arifaydogan0/Pulse-Oximeter/prototip.jpg

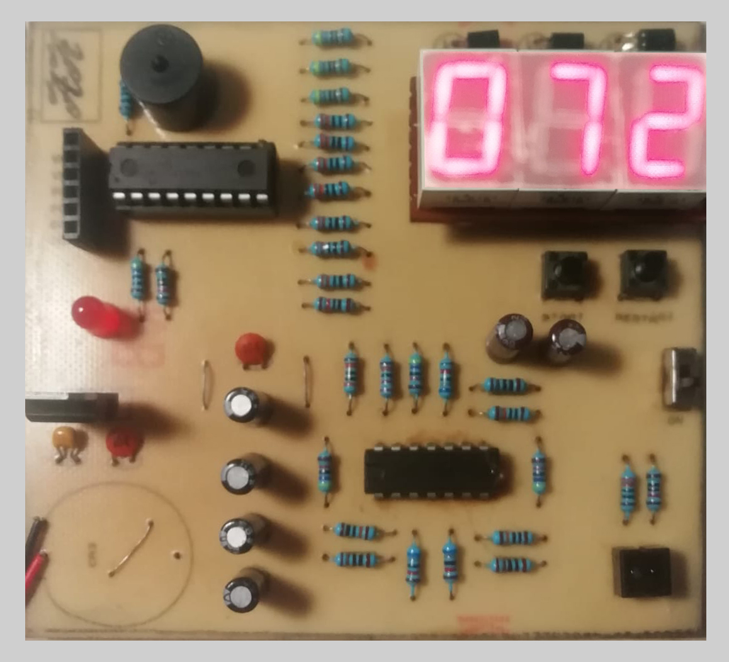
prototip.jpg
