arifaydogan0/Pulse-Oximeter/README.md

<h1 align="center">Pulse Oximeter</h1>
<li> Pic16F628A mikrodenetleyicisi ve CNY70 sensörü üzerine inşaa edilmiştir. </li>
<li> Parmak ucundan(kandaki CO2 miktarının değişiminden kaynaklı renk değişimini izleyerek) nabız ölçümü, %3 tolerans ile sonucu displayde gösterir.</li>

<br>
<br>

<h2 align="center">Devre Şeması</h2>

s0

<br>
<h2 align="center">Pcb Önizleme Ön</h2> 

top-silk

<br>
<h2 align="center">Pcb Önizleme Arka</h2>

bottom-copper

<br>
<h2 align="center">Pcb Önizleme 3D Visualizer</h2>

Ekran görüntüsü 2022-07-05 172732

<br>
<h2 align="center">Prototip</h2>

prototip
