arifaydogan0/Pulse-Oximeter/bottom-copper.png

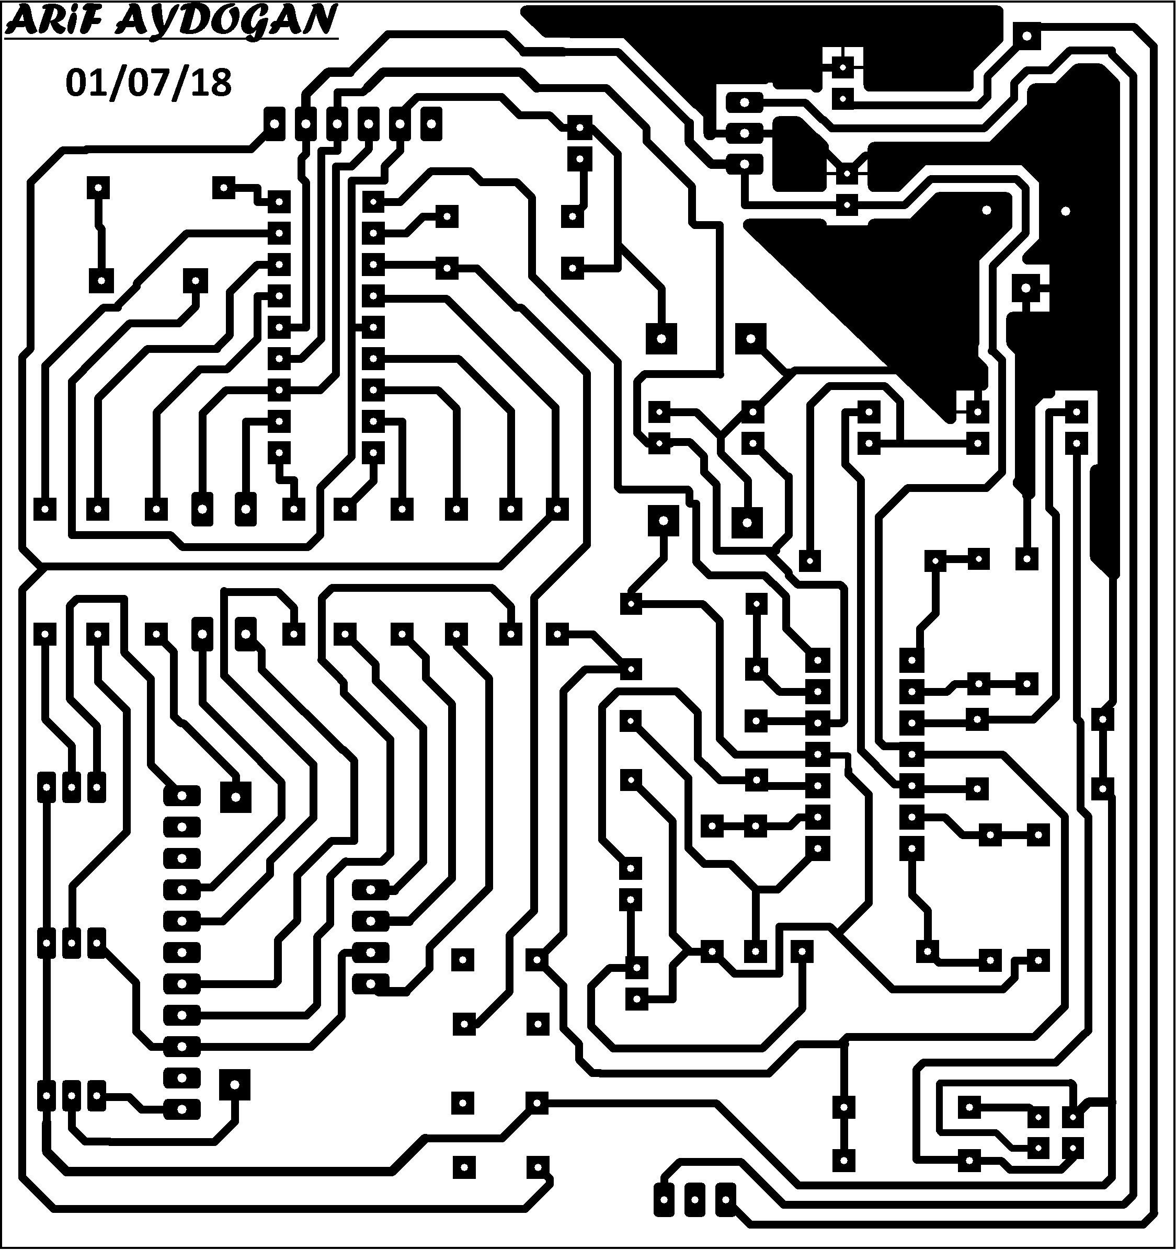
bottom-copper.png
