arifaydogan0/Pulse-Oximeter/Pulse Oximeter Proteus/Çıkarılacak/bottom copper (normal).bmp

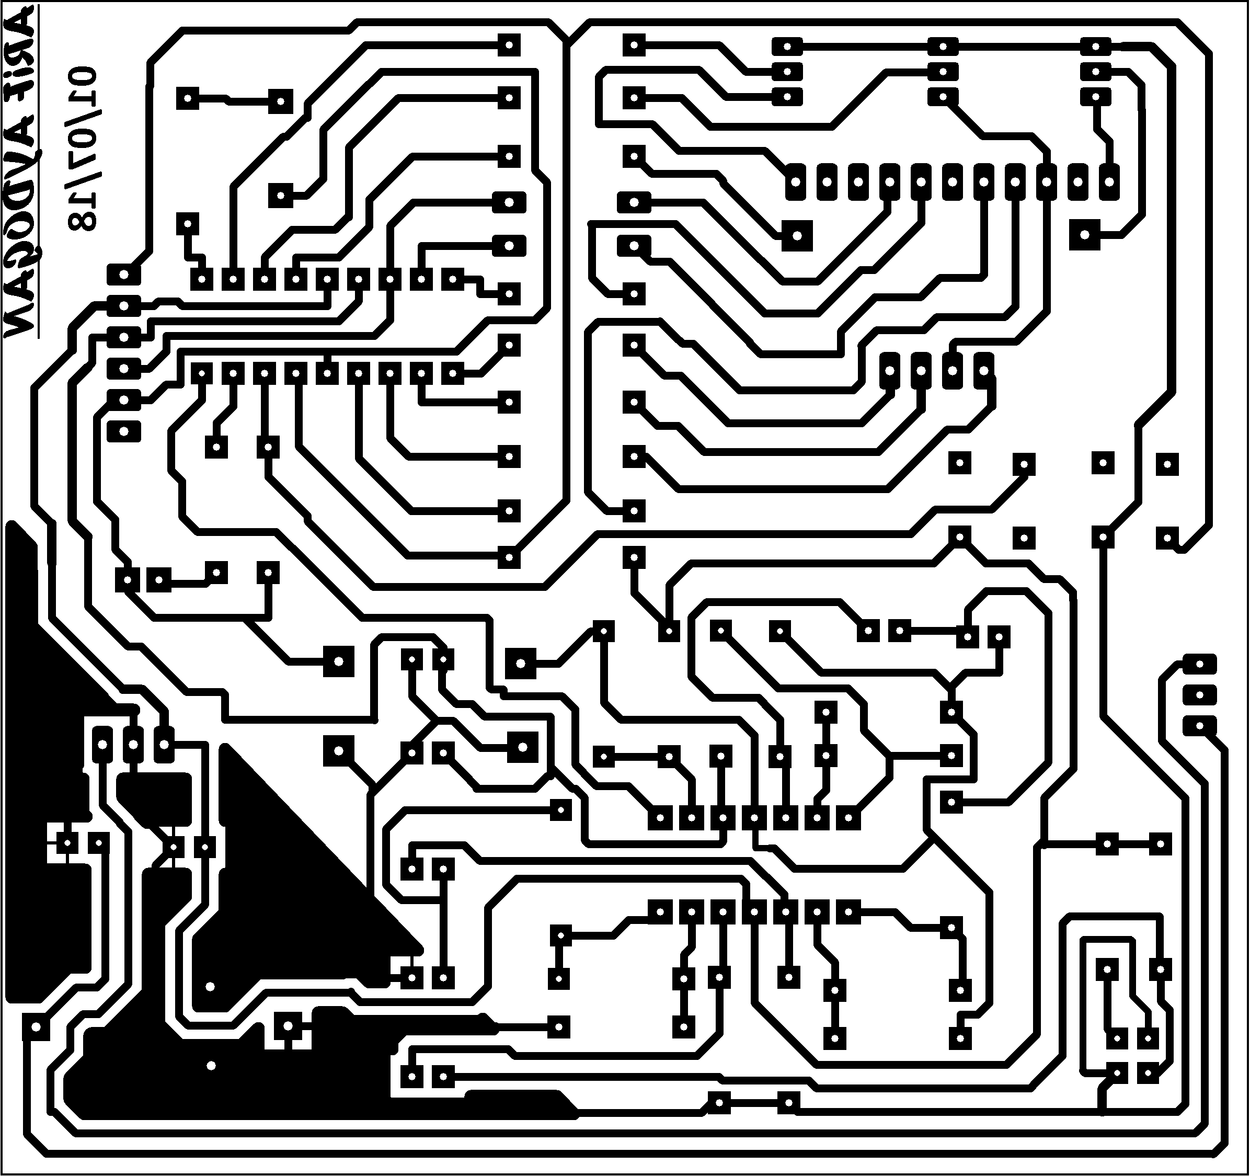
Pulse Oximeter Proteus/Çıkarılacak/bottom copper (normal).bmp
