arifaydogan0/Pulse-Oximeter/Pulse Oximeter Proteus/Çıkarılacak/top silk (ters).bmp

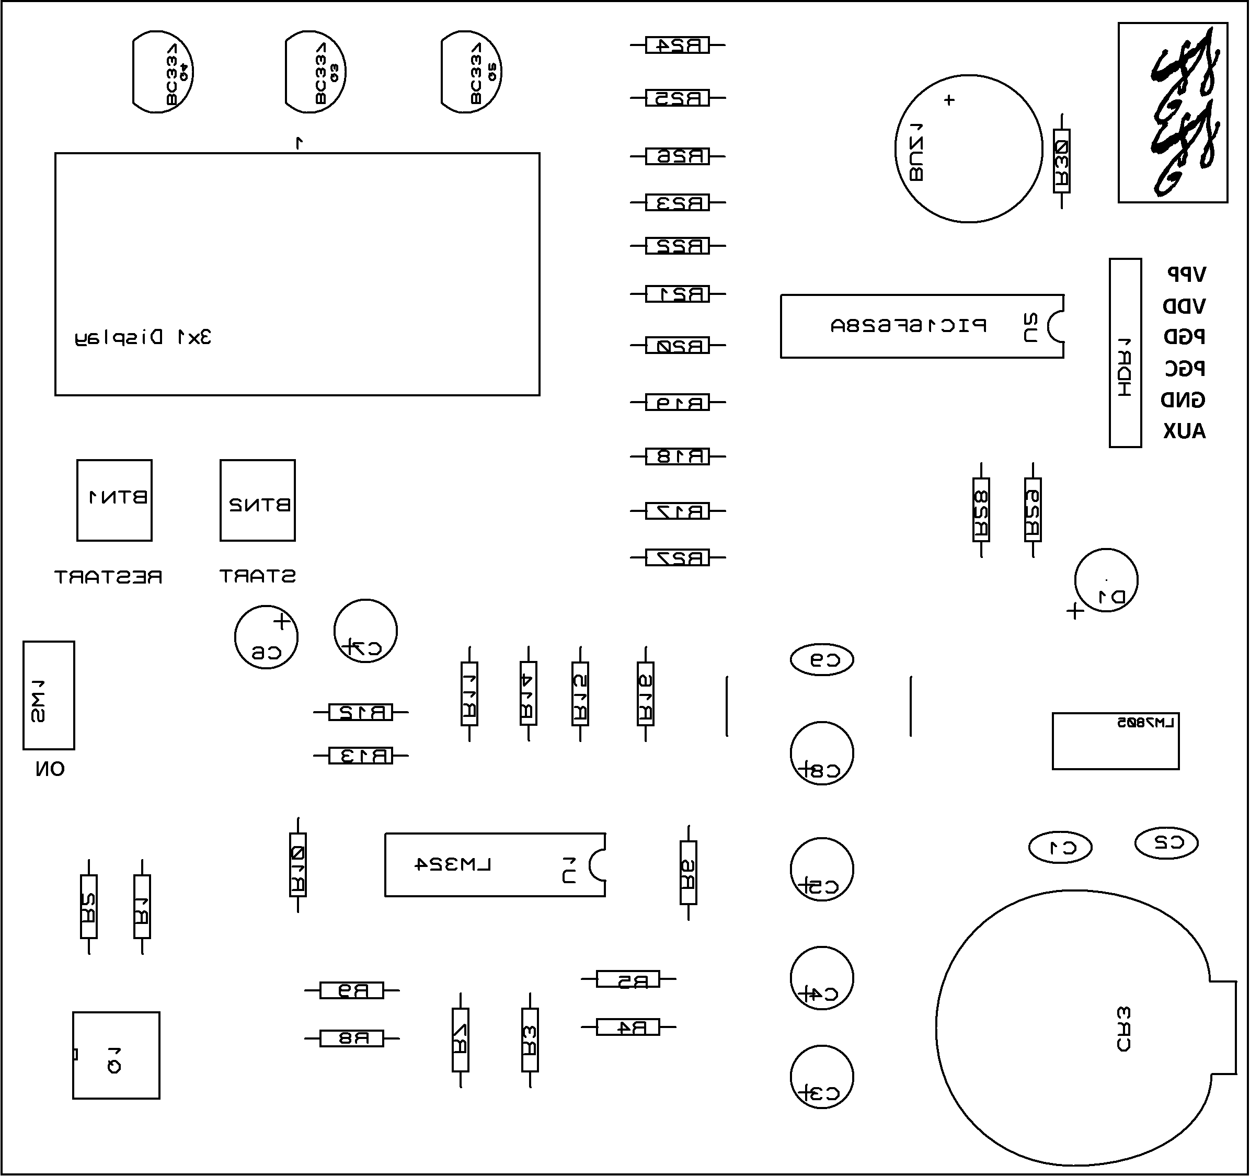
Pulse Oximeter Proteus/Çıkarılacak/top silk (ters).bmp
