arifaydogan0/Pulse-Oximeter/s0.png

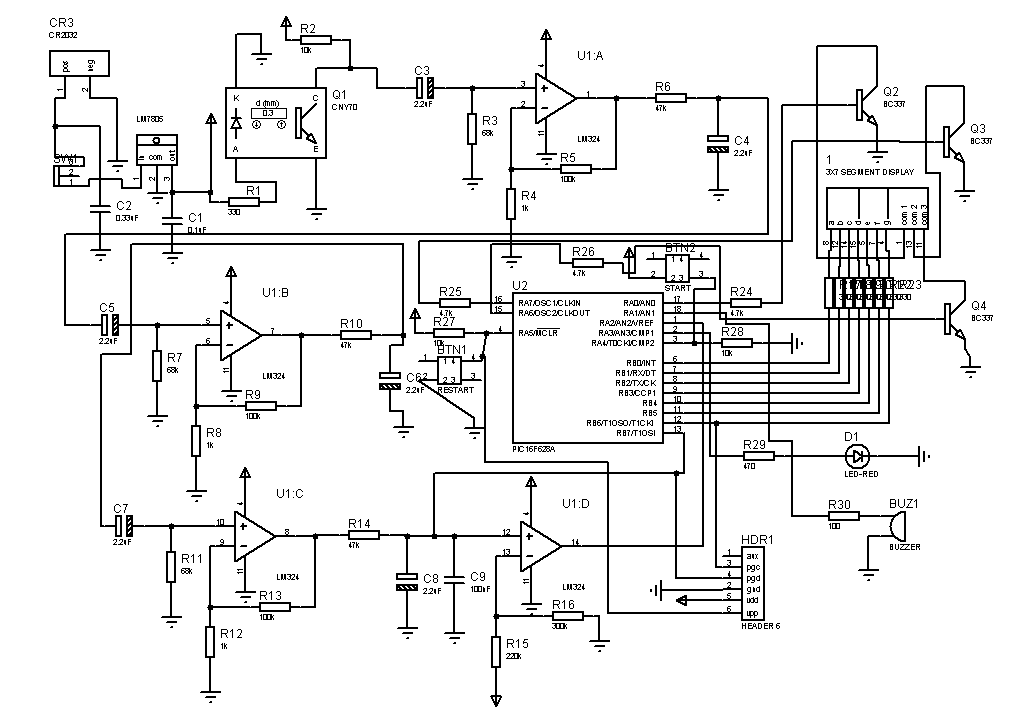
s0.png
