arifaydogan0/Pulse-Oximeter/top-silk.png

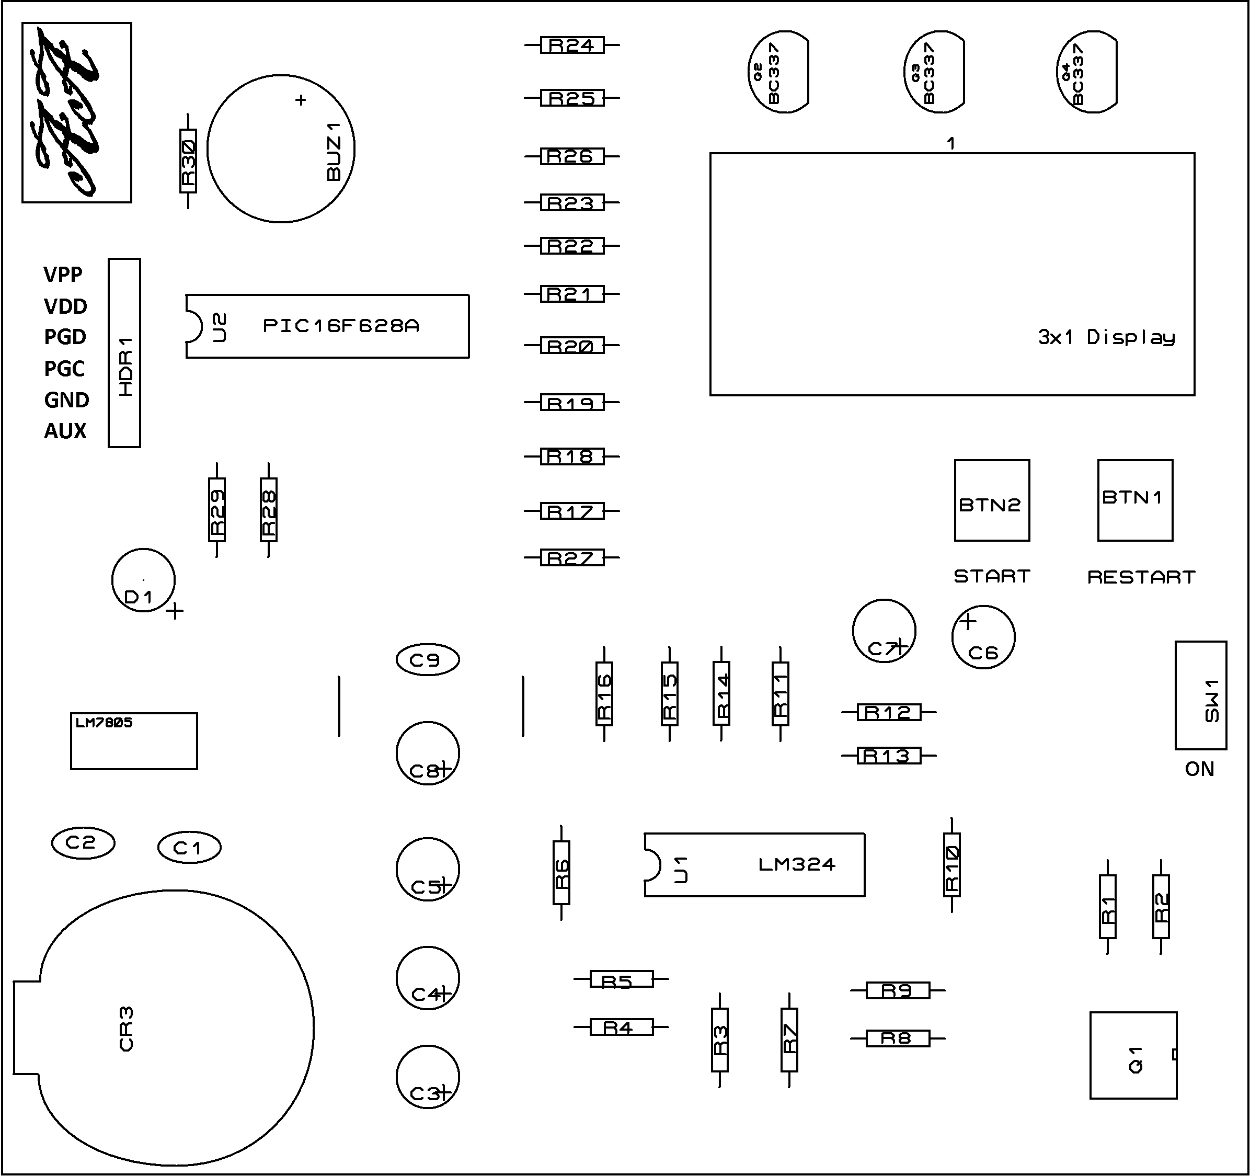
top-silk.png
