arifaydogan0/Pulse-Oximeter/Pulse Oximeter Proteus/Çıkarılacak/top silk(mirrorlanacak).pdf

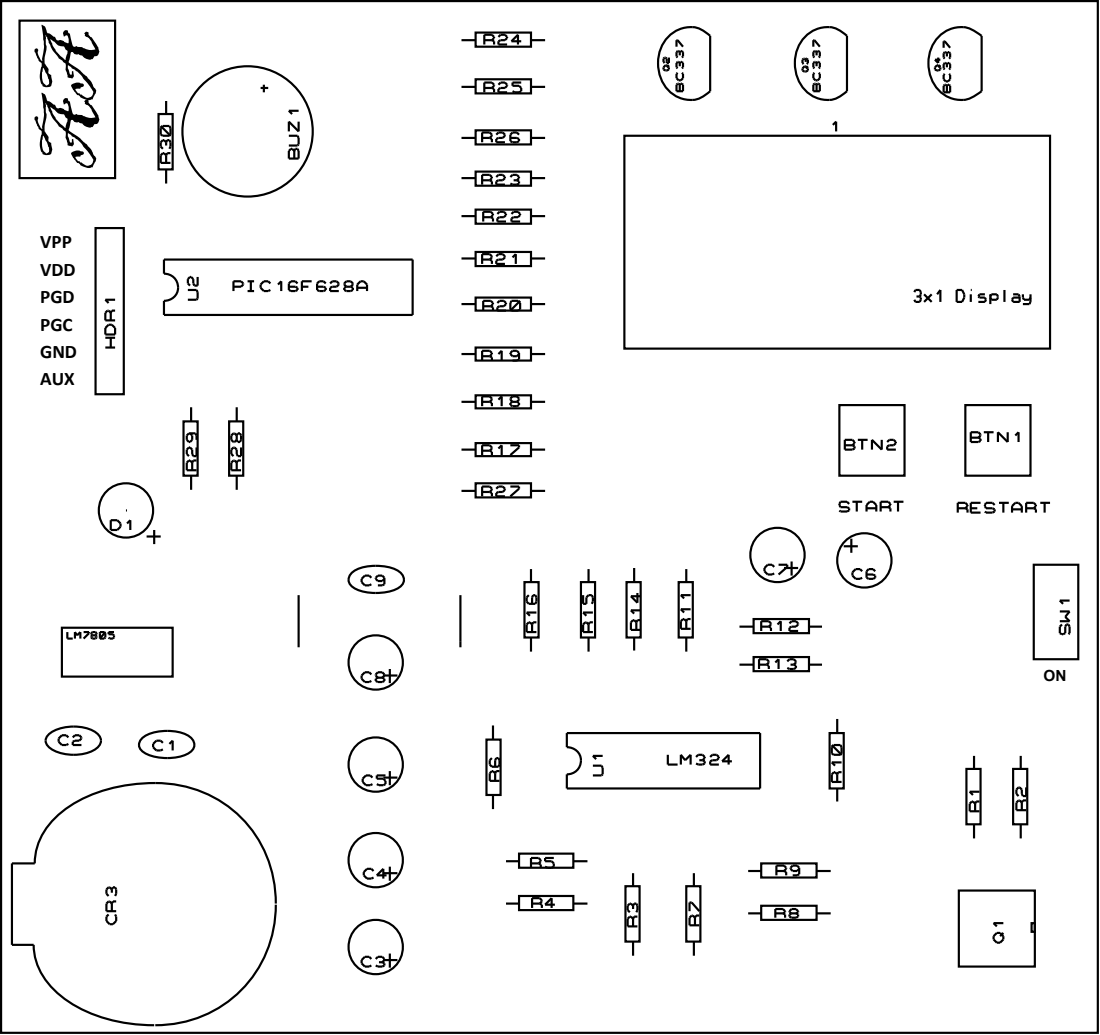
[picture p15: page 1]
AUX; GND; PGC; PGD; VDD; VPP
