arifaydogan0/Pulse-Oximeter/Pulse Oximeter Proteus/Çıkarılacak/bottom copper (mirrorlanacak).pdf

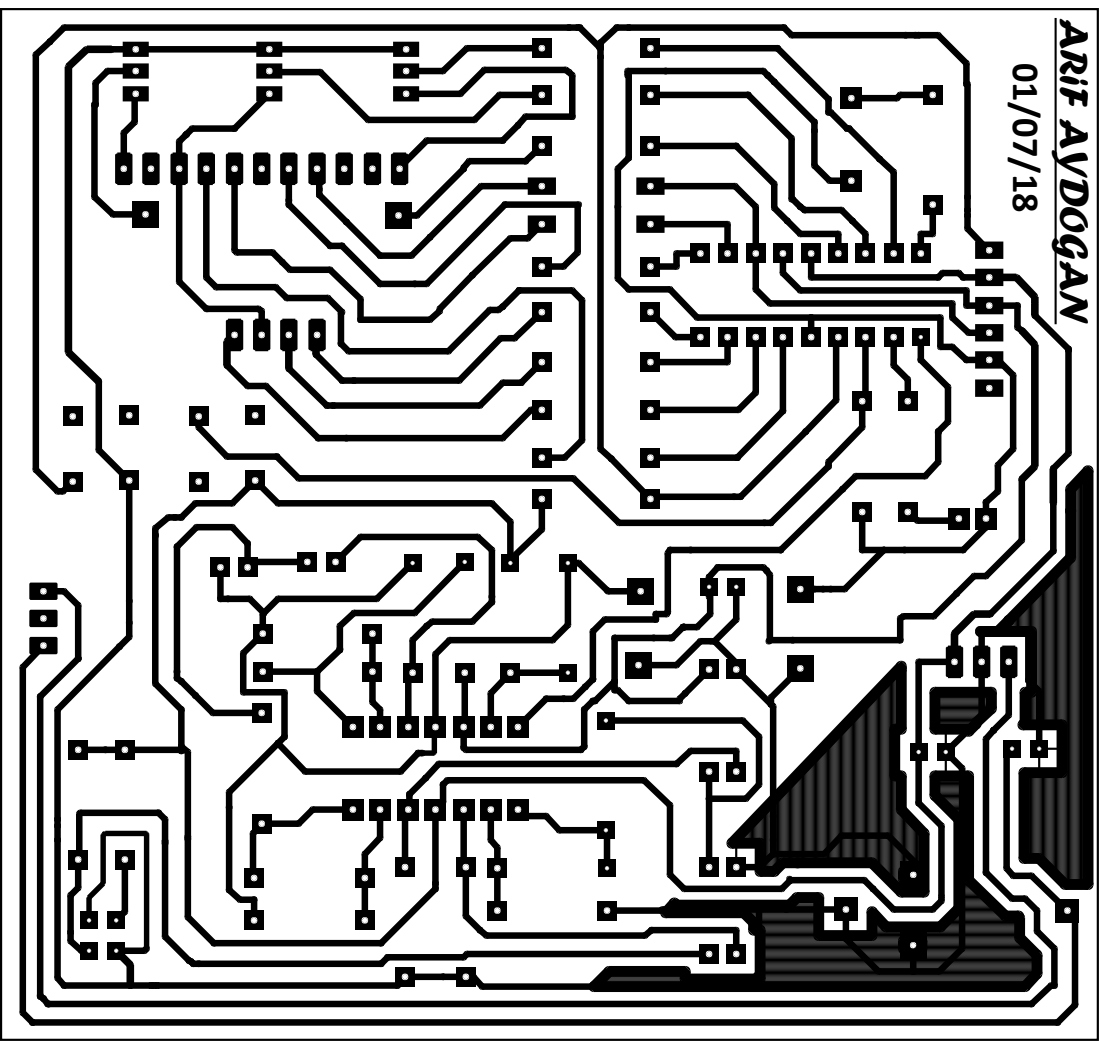
[picture p16: page 1]
ARiF AYDOGAN
