arifaydogan0/Pulse-Oximeter/(list of files, drawings)

Other design files:
Pulse Oximeter Proteus/New Project.pdsprj
